mswietlicki/jaskier-magnetmounts/drawer_mount_left.stl

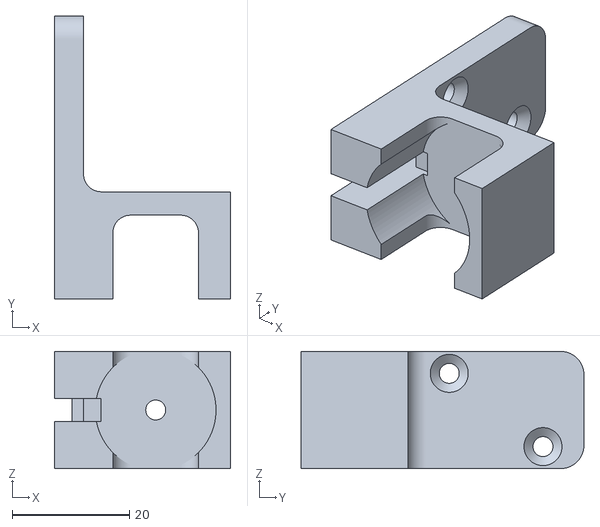
[picture p6: CAD file, 2026-10-14]
drawer_mount_left.stl
30.1 x 48.3 x 20.0
