mswietlicki/jaskier-magnetmounts/corner_mount_lowprofile.stl

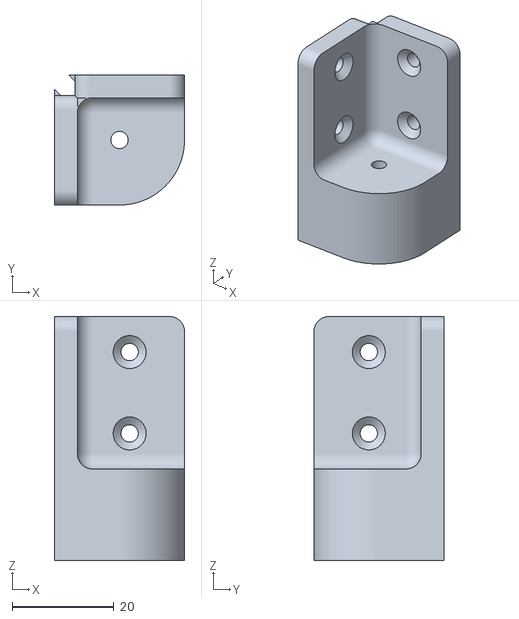
[picture p7: CAD file, 2026-10-14]
corner_mount_lowprofile.stl
25.6 x 25.6 x 48.0
