mswietlicki/jaskier-magnetmounts/corner_mount.stl

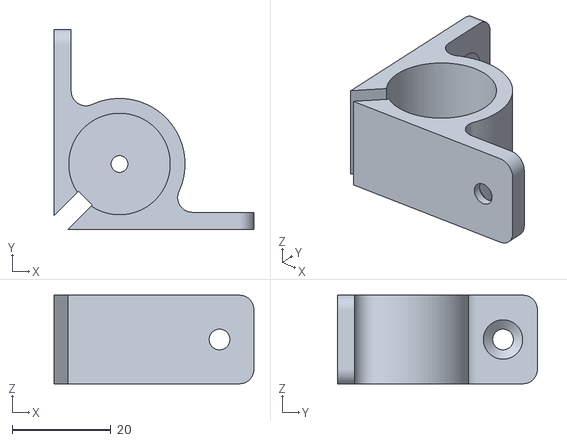
[picture p8: CAD file, 2026-10-14]
corner_mount.stl
40.6 x 40.6 x 18.0
