mswietlicki/jaskier-magnetmounts/(list of files, cad)

Other CAD files:
drawer_mount_right.stl
