mswietlicki/jaskier-magnetmounts/prusaslicer/magnet_mounts_COREONE_HF04_PETG.ini

# PrusaSlicer config bundle for the BR-20/15 magnet mounts (jaskier-megnets).
# Built from Prusa Research profiles 2.5.11. File > Import > Import Config Bundle.

[print:0.20mm STRUCTURAL Magnet mounts @COREONE HF0.4]
arc_fitting = emit_center
bottom_solid_layers = 4
bottom_solid_min_thickness = 0.5
bridge_acceleration = 1500
bridge_flow_ratio = 1
bridge_speed = 50
brim_separation = 0.1
brim_width = 3
compatible_printers_condition = printer_model=~/(COREONE|COREONEOAK|COREONEMMU3)/ and nozzle_diameter[0]==0.4 and nozzle_high_flow[0] and printer_notes!~/.*HT400.*/
default_acceleration = 3000
dont_support_bridges = 0
elefant_foot_compensation = 0.2
enable_dynamic_overhang_speeds = 1
external_perimeter_acceleration = 1500
external_perimeter_extrusion_width = 0.5
external_perimeter_speed = 50
external_perimeters_first = 0
extra_perimeters = 0
extrusion_width = 0.45
fill_angle = 45
fill_density = 50%
fill_pattern = gyroid
first_layer_acceleration = 500
first_layer_acceleration_over_raft = 0
first_layer_extrusion_width = 0.5
first_layer_height = 0.2
first_layer_infill_speed = 100
first_layer_speed = 45
first_layer_speed_over_raft = 30
gap_fill_enabled = 1
gap_fill_speed = 60
gcode_comments = 0
gcode_label_objects = firmware
gcode_resolution = 0.008
infill_acceleration = 6000
infill_anchor = 2
infill_anchor_max = 12
infill_every_layers = 1
infill_extruder = 1
infill_extrusion_width = 0.5
infill_first = 0
infill_overlap = 15%
infill_speed = 120
inherits = 0.25mm STRUCTURAL @COREONE HF0.4
interface_shells = 0
ironing_type = top
layer_height = 0.2
max_print_speed = 300
max_volumetric_extrusion_rate_slope_negative = 0
max_volumetric_extrusion_rate_slope_positive = 0
max_volumetric_speed = 0
min_bead_width = 85%
min_feature_size = 25%
min_skirt_length = 4
mmu_segmented_region_max_width = 5
only_retract_when_crossing_perimeters = 0
ooze_prevention = 0
output_filename_format = {input_filename_base}_0.4n_{layer_height}mm_{printing_filament_types}_{printer_model}_{print_time}.gcode
over_bridge_speed = 50%
overhang_speed_0 = 15
overhang_speed_1 = 25
overhang_speed_2 = 45
overhang_speed_3 = 90%
overhangs = 1
perimeter_acceleration = 2500
perimeter_extruder = 1
perimeter_extrusion_width = 0.5
perimeter_generator = arachne
perimeter_speed = 70
perimeters = 5
raft_contact_distance = 0.15
raft_expansion = 1.5
raft_first_layer_density = 90%
raft_first_layer_expansion = 3
seam_position = aligned
single_extruder_multi_material_priming = 0
skirts = 0
slice_closing_radius = 0.049
small_perimeter_speed = 50
solid_infill_acceleration = 4000
solid_infill_below_area = 15
solid_infill_every_layers = 0
solid_infill_extruder = 1
solid_infill_extrusion_width = 0.5
solid_infill_speed = 140
support_material = 1
support_material_angle = 0
support_material_auto = 1
support_material_bottom_contact_distance = 0
support_material_bottom_interface_layers = 0
support_material_buildplate_only = 1
support_material_closing_radius = 2
support_material_contact_distance = 0.2
support_material_enforce_layers = 0
support_material_extruder = 0
support_material_extrusion_width = 0.4
support_material_interface_contact_loops = 0
support_material_interface_extruder = 0
support_material_interface_layers = 3
support_material_interface_pattern = auto
support_material_interface_spacing = 0.2
support_material_interface_speed = 50
support_material_pattern = rectilinear
support_material_spacing = 2
support_material_speed = 120
support_material_style = snug
support_material_synchronize_layers = 0
support_material_threshold = 40
support_material_with_sheath = 0
support_material_xy_spacing = 80%
support_tree_angle = 40
support_tree_angle_slow = 25
support_tree_branch_diameter = 2
support_tree_branch_diameter_angle = 5
support_tree_branch_diameter_double_wall = 8
support_tree_branch_distance = 1
support_tree_tip_diameter = 0.8
support_tree_top_rate = 30%
thick_bridges = 0
thin_walls = 0
top_fill_pattern = monotoniclines
top_infill_extrusion_width = 0.42
top_solid_infill_acceleration = 2000
top_solid_infill_speed = 80
top_solid_layers = 5
top_solid_min_thickness = 0.7
travel_acceleration = 7000
travel_short_distance_acceleration = 250
travel_speed = 350
travel_speed_z = 12
wipe_tower = 1
wipe_tower_acceleration = 0
wipe_tower_cone_angle = 25
wipe_tower_extra_flow = 250%
wipe_tower_extra_spacing = 110%

[filament:Prusament PETG Magnet mounts @COREONE HF0.4]
bed_temperature = 85
bridge_fan_speed = 60
chamber_minimal_temperature = 0
chamber_temperature = 35
compatible_printers = 
compatible_printers_condition = printer_model=~/(COREONE|COREONEOAK|COREONEMMU3|COREONEL|COREONELMMU3)/ and nozzle_diameter[0]!=0.8 and nozzle_diameter[0]!=0.6 and nozzle_diameter[0]!=0.5 and nozzle_high_flow[0]
cooling = 1
cooling_perimeter_transition_distance = 10
cooling_slowdown_logic = consistent_surface
disable_fan_first_layers = 3
enable_dynamic_fan_speeds = 1
end_filament_gcode = "; Filament-specific end gcode"
extrusion_multiplier = 1
fan_always_on = 1
fan_below_layer_time = 25
filament_colour = #FF8000
filament_cooling_final_speed = 2.5
filament_cooling_initial_speed = 5
filament_cooling_moves = 3
filament_cost = 29.99
filament_density = 1.27
filament_diameter = 1.75
filament_infill_max_crossing_speed = 110
filament_infill_max_speed = 200
filament_load_time = 10.9
filament_loading_speed = 10
filament_loading_speed_start = 50
filament_max_volumetric_speed = 24
filament_minimal_purge_on_wipe_tower = 35
filament_notes = ""
filament_ramming_parameters = "250 100 42.4194 42.4194| 0.05 42.4387 0.45 42.4387 0.95 42.4387 1.45 42.4387 1.95 42.4387 2.45 42.4387 2.95 42.4387 3.45 42.4387 3.95 42.4387 4.45 42.4387 4.95 42.4387"
filament_retract_before_wipe = 20
filament_retract_length = 0.8
filament_retract_lift = 0.15
filament_settings_id = ""
filament_soluble = 0
filament_spool_weight = 278
filament_stamping_distance = 45
filament_stamping_loading_speed = 26.5
filament_toolchange_delay = 0
filament_travel_max_lift = 1.5
filament_travel_ramping_lift = 1
filament_travel_slope = 1
filament_type = PETG
filament_unload_time = 8.9
filament_unloading_speed = 60
filament_unloading_speed_start = 60
filament_vendor = Prusa Polymers
filament_wipe = 1
first_layer_bed_temperature = 85
first_layer_temperature = 255
full_fan_speed_layer = 5
idle_temperature = 130
inherits = Prusament PETG @COREONE HF0.4
max_fan_speed = 35
min_fan_speed = 15
min_print_speed = 15
overhang_fan_speed_0 = 60
slowdown_below_layer_time = 9
start_filament_gcode = "M572 S{if nozzle_diameter[filament_extruder_id]==0.4}0.047{elsif nozzle_diameter[filament_extruder_id]==0.5}0.042{elsif nozzle_diameter[filament_extruder_id]==0.6}0.033{elsif nozzle_diameter[filament_extruder_id]==0.8}0.021{elsif nozzle_diameter[filament_extruder_id]==0.25}0.17{elsif nozzle_diameter[filament_extruder_id]==0.3}0.09{else}0{endif} ; Filament gcode\n\nM142 S36 ; set heatbreak target temp"
temperature = 260

[filament:Generic PETG Magnet mounts @COREONE HF0.4]
bed_temperature = 85
bridge_fan_speed = 60
chamber_minimal_temperature = 0
chamber_temperature = 35
compatible_printers = 
compatible_printers_condition = printer_model=~/(COREONE|COREONEOAK|COREONEMMU3|COREONEL|COREONELMMU3)/ and nozzle_diameter[0]!=0.8 and nozzle_diameter[0]!=0.6 and nozzle_diameter[0]!=0.5 and nozzle_high_flow[0]
cooling = 1
cooling_perimeter_transition_distance = 10
cooling_slowdown_logic = consistent_surface
disable_fan_first_layers = 3
enable_dynamic_fan_speeds = 1
end_filament_gcode = "; Filament-specific end gcode"
extrusion_multiplier = 1
fan_always_on = 1
fan_below_layer_time = 25
filament_colour = #FF8000
filament_cooling_final_speed = 2.5
filament_cooling_initial_speed = 5
filament_cooling_moves = 3
filament_cost = 27.82
filament_density = 1.27
filament_diameter = 1.75
filament_infill_max_crossing_speed = 110
filament_infill_max_speed = 200
filament_load_time = 10.9
filament_loading_speed = 10
filament_loading_speed_start = 50
filament_max_volumetric_speed = 21
filament_minimal_purge_on_wipe_tower = 35
filament_notes = ""
filament_ramming_parameters = "250 100 42.4194 42.4194| 0.05 42.4387 0.45 42.4387 0.95 42.4387 1.45 42.4387 1.95 42.4387 2.45 42.4387 2.95 42.4387 3.45 42.4387 3.95 42.4387 4.45 42.4387 4.95 42.4387"
filament_retract_before_wipe = 20
filament_retract_length = 0.8
filament_retract_lift = 0.15
filament_settings_id = ""
filament_soluble = 0
filament_stamping_distance = 45
filament_stamping_loading_speed = 26.5
filament_toolchange_delay = 0
filament_travel_max_lift = 1.5
filament_travel_ramping_lift = 1
filament_travel_slope = 1
filament_type = PETG
filament_unload_time = 8.9
filament_unloading_speed = 60
filament_unloading_speed_start = 60
filament_vendor = Generic
filament_wipe = 1
first_layer_bed_temperature = 85
first_layer_temperature = 250
full_fan_speed_layer = 5
idle_temperature = 130
inherits = Generic PETG @COREONE HF0.4
max_fan_speed = 35
min_fan_speed = 15
min_print_speed = 15
overhang_fan_speed_0 = 60
renamed_from = "Generic PET"
slowdown_below_layer_time = 9
start_filament_gcode = "M572 S{if nozzle_diameter[filament_extruder_id]==0.4}0.047{elsif nozzle_diameter[filament_extruder_id]==0.5}0.042{elsif nozzle_diameter[filament_extruder_id]==0.6}0.033{elsif nozzle_diameter[filament_extruder_id]==0.8}0.021{elsif nozzle_diameter[filament_extruder_id]==0.25}0.17{elsif nozzle_diameter[filament_extruder_id]==0.3}0.09{else}0{endif} ; Filament gcode\n\nM142 S36 ; set heatbreak target temp"
temperature = 255

[presets]
print = 0.20mm STRUCTURAL Magnet mounts @COREONE HF0.4
filament = Prusament PETG Magnet mounts @COREONE HF0.4
printer = Prusa CORE One HF0.4 nozzle
