mswietlicki/jaskier-magnetmounts/(commit log)

2026-10-14 Add low-profile corner mount with rear tabs
    Third BR-20/15 mount: same corner position and 45 degree cable slot as
    corner_mount.scad, but the front is only a 2.5 mm shell around the magnet
    (25.6 mm square, one rounded corner) with no side flanges. Two 4.5 mm tabs
    run 30 mm along the wall and shelf behind the back plate and take the wood
    screws, hidden from the front like the drawer mount. The tabs stop short of
    the corner so the lead runs along the open corner between them.
    Tabs are 4.5 mm against a 4 mm slot on purpose: equal sizes leave the two
    tabs touching along a line and the export is not manifold, so the file
    asserts that they differ. Prints front face down with one 20.6 mm bridge.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
    [corner_mount_lowprofile.scad, corner_mount_lowprofile.stl]
2026-10-14 Add renders and electromagnet specs to README
    Embed the existing preview renders so the README shows what each mount
    looks like, and add an Electromagnet section linking the BR-20/15 product
    page with its specs. Note the M4 variant and the rear_screw_d setting
    needed to use it.
2026-10-14 Add low profile corner mount renders to README
    The README renders were added on a branch cut before the low profile
    corner mount landed, so it was missing from the intro, the render table
    and the STL list.
2026-10-14 Round the load-bearing inner corners of all mounts
    The mounts are printed front face down with supports, so the joints
    between body and flanges/tabs sit on layer lines and the sharp inner
    corners there are the first place they crack. All three designs get a
    new fillet_r parameter (default 3 mm, 0 = sharp):
    * corner mount: flanges to the round body, where the flange top met the
    body at a ~42 degree notch. The fillet is part of the extruded XZ
    profile and stops ~1.5 mm short of the countersinks.
    * low profile: both tabs to the back plate, and the inside corner of the
    L between the two tabs, which were only joined by a 0.5 x 0.5 mm
    overlap. A revolved piece carries the back plate fille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
    [corner_mount.scad, corner_mount.stl, corner_mount_lowprofile.scad, corner_mount_lowprofile.stl, drawer_mount.scad, drawer_mount_left.stl, drawer_mount_right.stl]
2026-10-14 Add PrusaSlicer profile for the CORE One / One+ with PETG
    Config bundle with a print preset and two PETG filament presets for the
    stock 0.4 HF nozzle, built from the Prusa Research system profiles
    2.5.11. Every preset carries its full resolved settings plus "inherits"
    so PrusaSlicer shows what differs from the Prusa parent. A partial file
    would get PrusaSlicer defaults, not the parent's values, for every
    missing key.
    Print (from 0.25mm STRUCTURAL @COREONE HF0.4): 0.2 mm layers,
    5 perimeters, 5/4 solid layers, 50 % gyroid, solid infill below 15 mm2,
    supports on build plate only with 0.2 mm contact gap, 3 mm brim.
    Filament (Prusament and Generic PETG @COREONE HF0.4): +5 C nozzle after
    the fir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
    [magnet_mounts_COREONE_HF04_PETG.ini]
